kinsamanka/PICnc-V2/README.md

PICnc-V2
========

PICnc V2 is a PIC32 based hardware step generator board that is designed for MachineKit
