kinsamanka/PICnc-V2/(threads)

Thread 2 (2015-08-28):

Odroid compile vor image

magnifikus, 2015-08-28:
Im missing instructions to geht it working in the odroid, i the machinekit image You posted in odroid Forums (from march) but it seems to miss the drivers. Anyone bot an working image or do i have to Compiler linuxcnc myself?

Thanks in advance :)

adbensi, 2015-08-28:
Hello,
If You have Debian, You not need to build it, You can use debian package or
pre-build image iso. You can build too, but I can make it on Ubuntu with
old machinekit source.

But if You can open machinekit, then You need the picnc SPI source and HAL
files. You find it on the repository. What is Your version of the board?
Em 28/08/2015 15:25, "magnifikus" <notifications@github.com> escreveu:

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

magnifikus, 2015-08-29:
Using debian 7.8 with Linux machinekit 3.10.70-rt71 #1 SMP PREEMPT RT Fri Mar 13 06:54:06 UTC 2015 armv7l GNU/Linux

linuxcnc is sadly reporting as machinekit 0.1

if i run the test from the wiki its telling me the picnc module is missing, but i have no clue how to compile it and found nothing on the web.

if you have a tip, howto compile it would be nice

best regards

Moritz Kunze

kinsamanka, 2015-08-29:
If you have preempt_rt kernel running on Odriod, you can just follow the
instructions on the machinekit website on using the debian packages.

The 0.1 version is fixed, the actual version can be found on the log file.

Have you built the picnc board?
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

magnifikus, 2015-08-29:
yeah i created a prototype, the status is blinking, will experiment abit, and sorry for spamming issues here

magnifikus, 2015-08-29:
seems like its a bummer, kernel upgrade not working and the default kernel is crashing randomly (some kernel panic, could not write down :()

will try raspberry2, odroid seems to be engineered bad anyway.... guess you can close this :)

magnifikus, 2015-08-29:
sudo comp --install picnc.c  is btw the command i was looking for ;)

Closed 2015-08-29.

Thread 3 (2015-09-09):

Weired Missplacing

magnifikus, 2015-09-09:
Asking if someone uses picncv2 successfull and noticed random displacement of axis during programms.

Config is:
MAX_VELOCITY = 30
MAX_ACCELERATION = 40
STEPGEN_MAXACCEL = 45
SCALE = 640.0

running with G64 P0.05

wired happens sometime during programms, suddenly the X-Axis is ~20mm out of place, maybe someone had this issue also :)

running machinekit on odroid c1 with preempt

best regards

adbensi, 2015-09-09:
I use, I will simulate this... best regards
Em 09/09/2015 13:24, "magnifikus" <notifications@github.com> escreveu:

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

kinsamanka, 2015-09-09:
Do you observe this problem when using the sim configuration?

Please check the status of the picnc.spi_fault signal.

Asking if someone uses picncv2 successfull and noticed random displacement
of axis during programms.

Config is:
MAX_VELOCITY = 30
MAX_ACCELERATION = 40
STEPGEN_MAXACCEL = 45
SCALE = 640.0

running with G64 P0.05

wired happens sometime during programms, suddenly the X-Axis is ~20mm out
of place, maybe someone had this issue also :)

running machinekit on odroid c1 with preempt

best regards

—
Reply to this email directly or view it on GitHub
<https://github.com/kinsamanka/PICnc-V2/issues/3>.

Closed 2015-12-29.

Thread 5 (2015-12-18):

Need driver enable control

n9wxu, 2015-12-18:
Is the driver enable to be controlled by the PICnc automatically (ie. no steps in a while.. disable the driver) or should the enable outputs be controlled by machinekit?

kinsamanka, 2015-12-18:
The drive enabled pin is controlled by machinekit. But all the digital outputs are interlocked with the SPI communication, if there's activity on the SPI all the output pins will be cleared.

n9wxu, 2015-12-18:
So I simply need to map the enables to something in machine kit and the SPI update will drive the enables suitably?

I should probably de-assert the enables should the SPI timeout as well.

n9wxu, 2015-12-20:
Enable works...
Enable deasserts when the SPI timeouts.

Closed 2015-12-20.
