kinsamanka/PICnc-V2/hardware/LPT/PICnc_V2.pdf

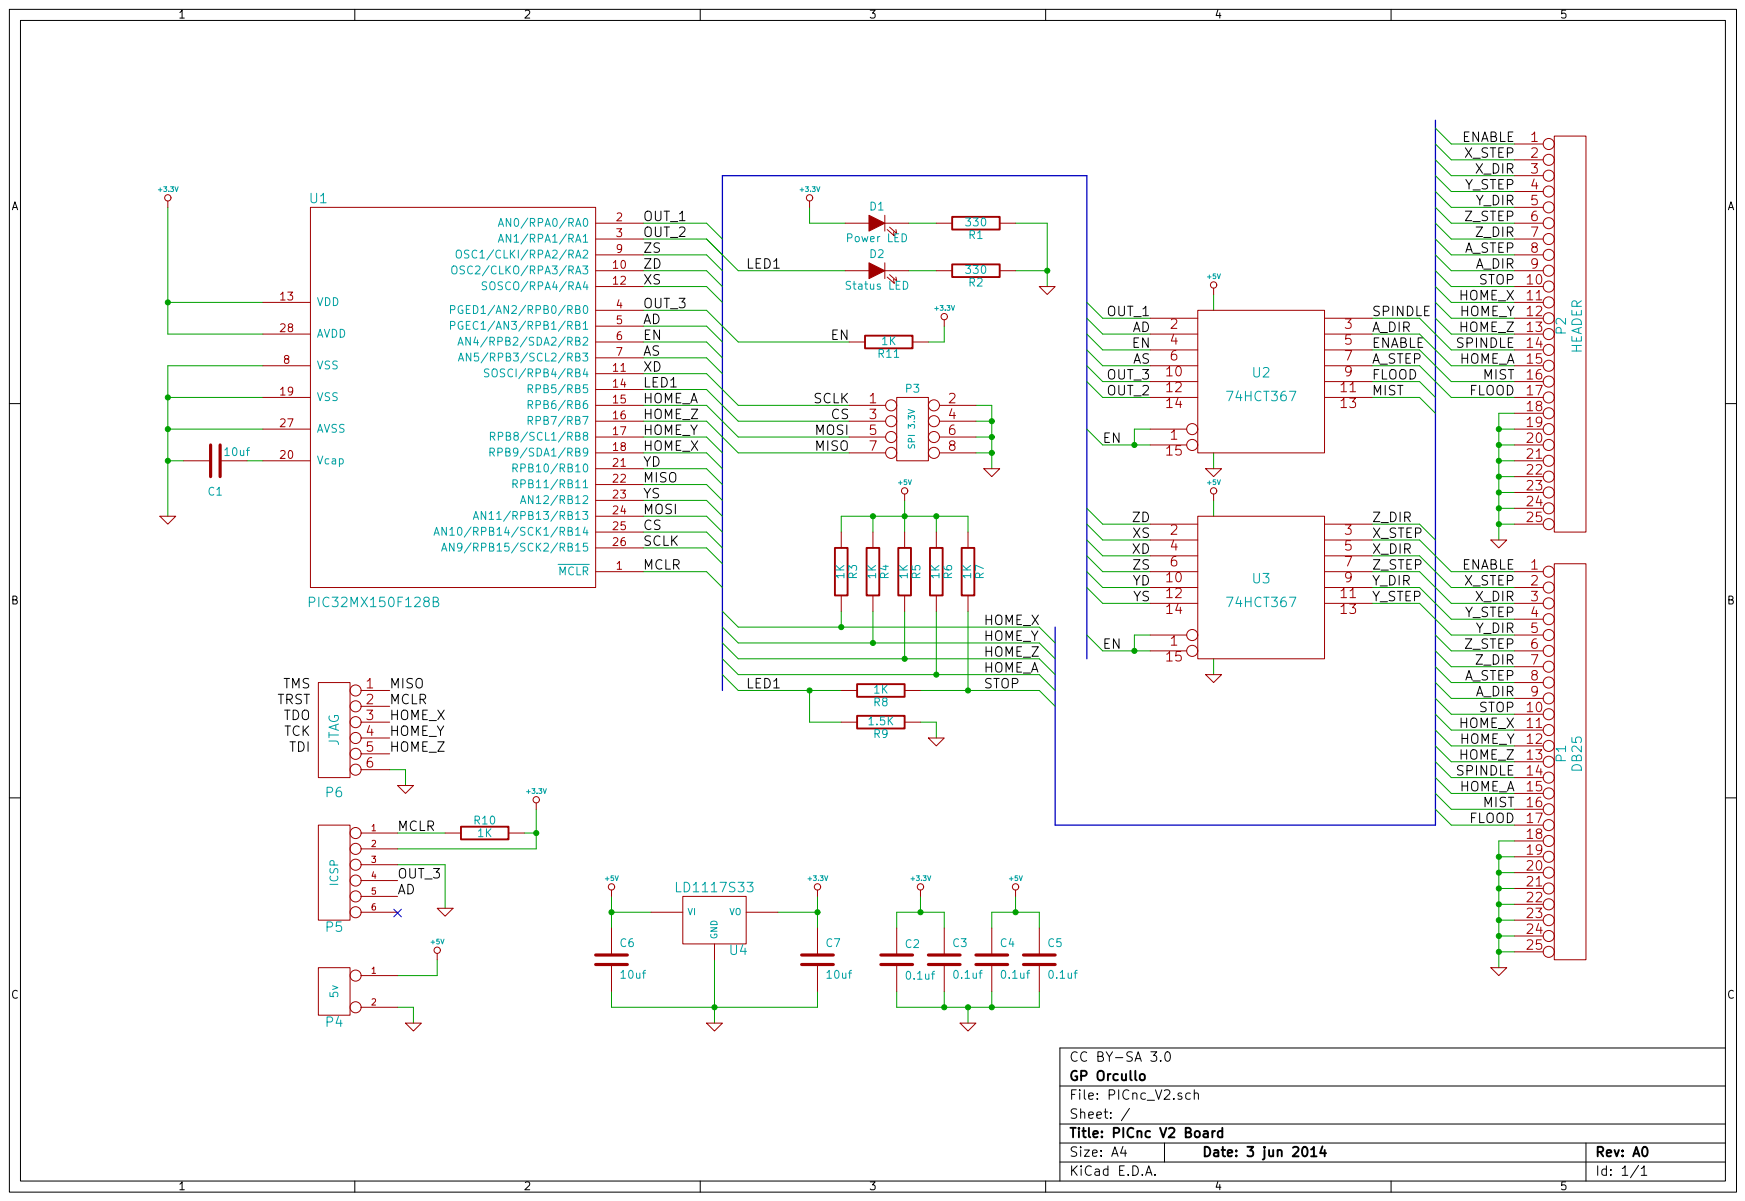
[picture p1: page 1]
