kinsamanka/PICnc-V2/hardware/Pololu/PICnc_V2_1.pdf

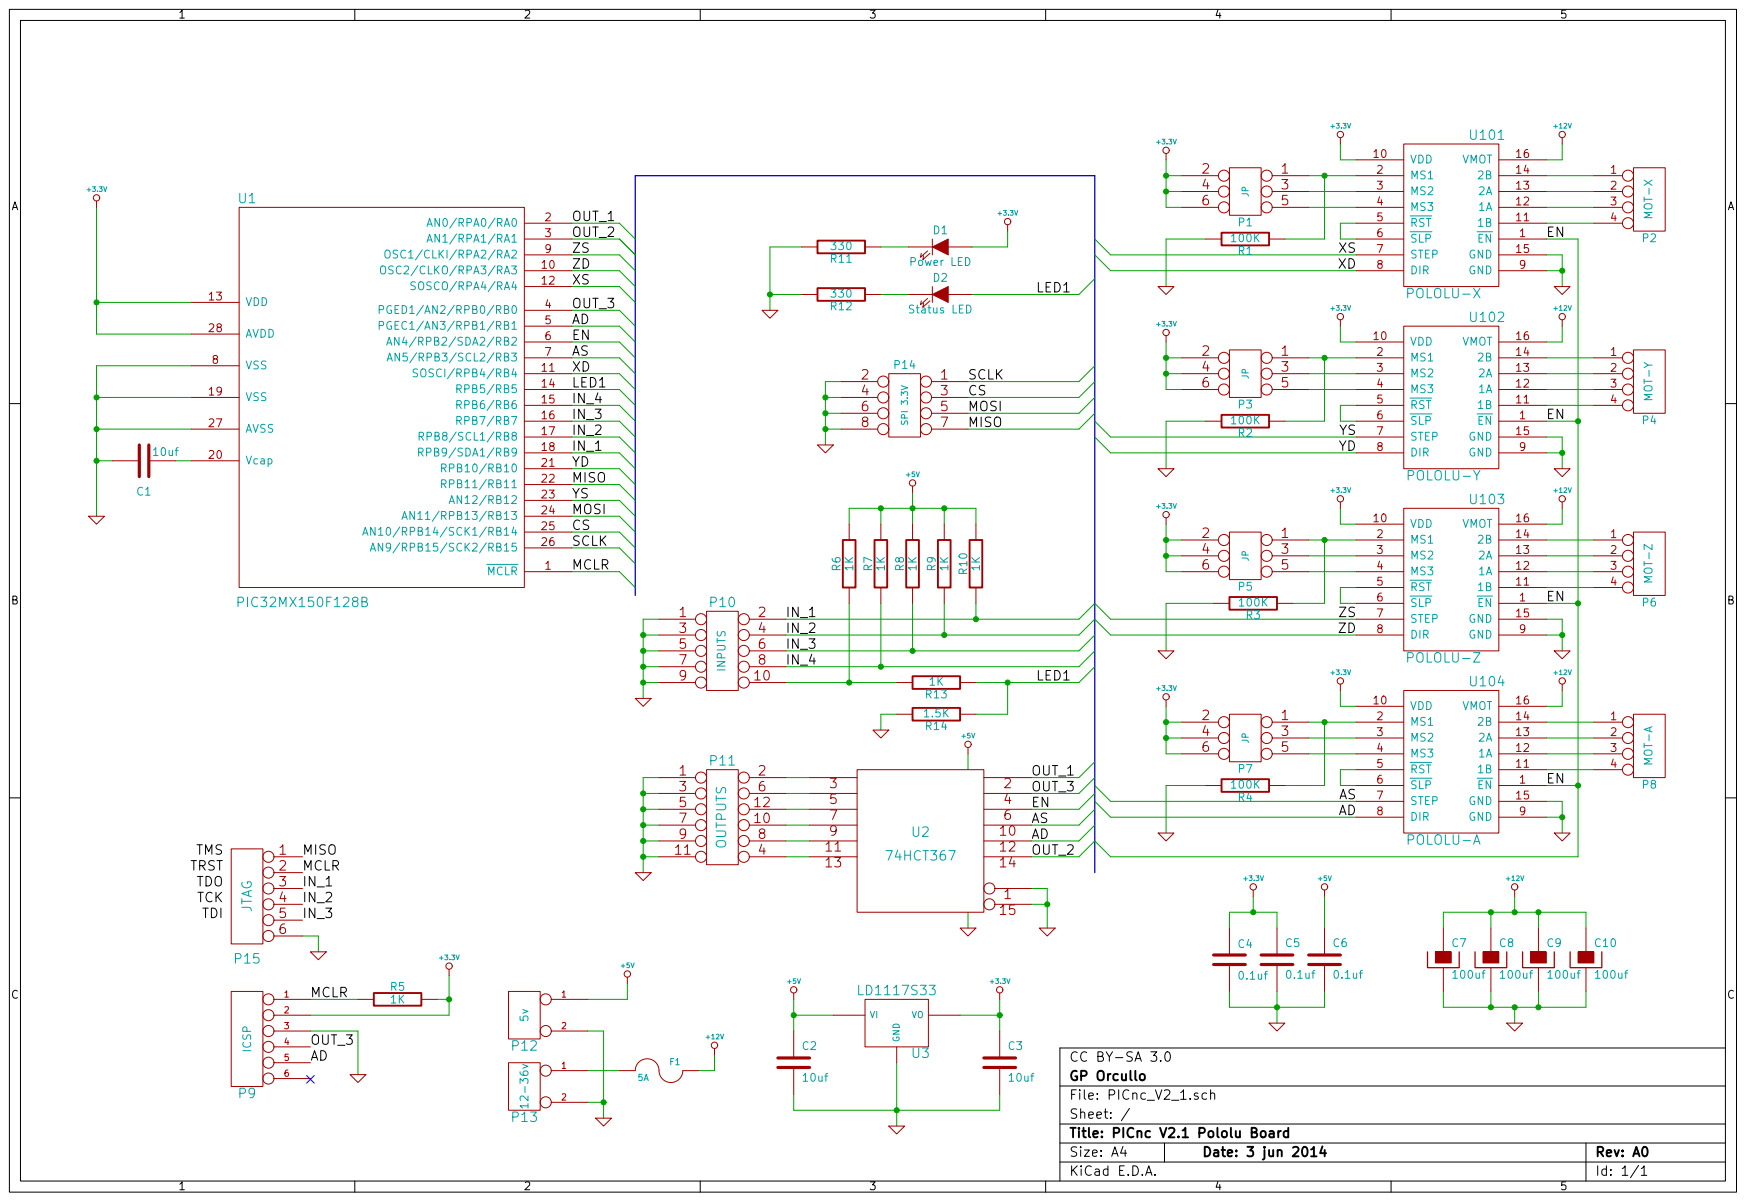
[picture p6: page 1]
