kinsamanka/PICnc-V2/hardware/Pololu/PICnc_V2_1_brd.pdf

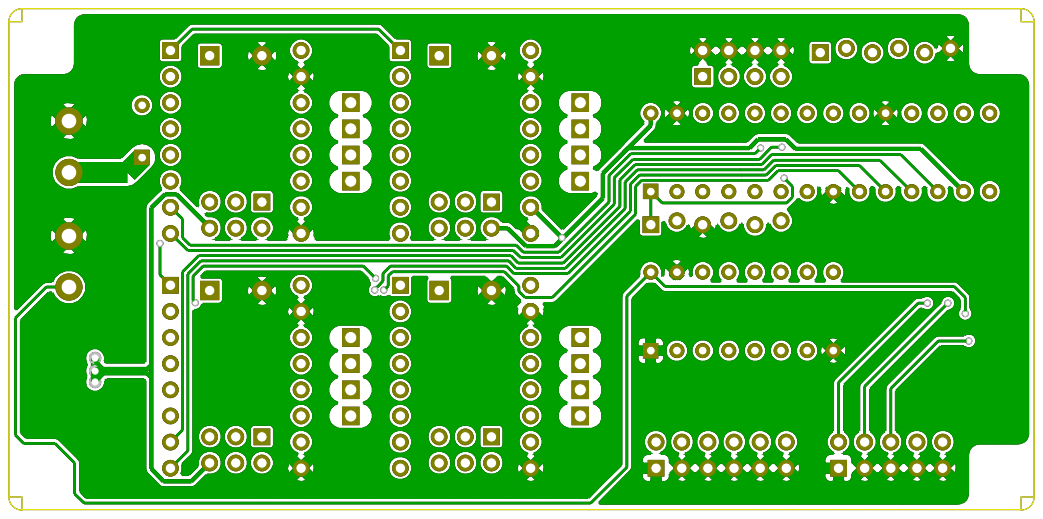
[picture p7: page 1]

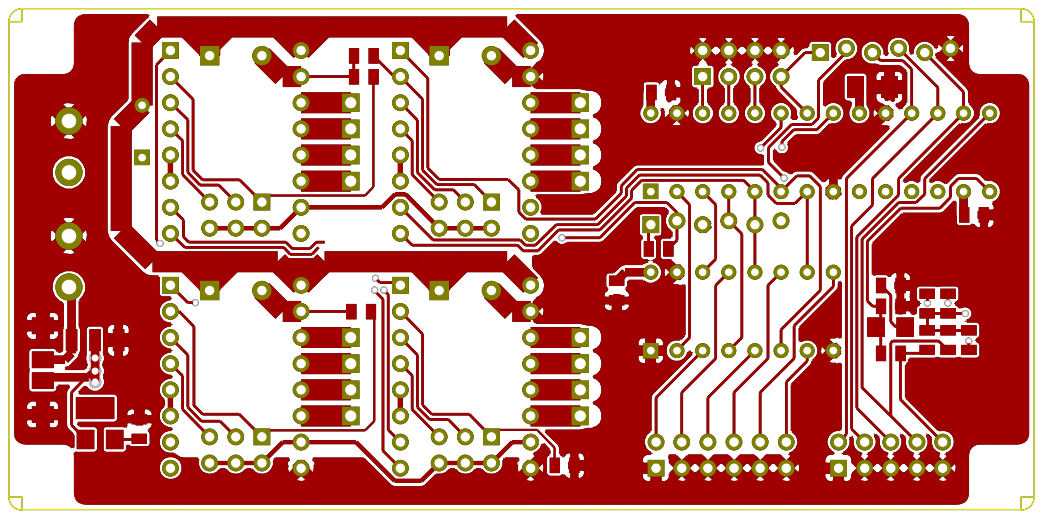
[picture p8: page 2]

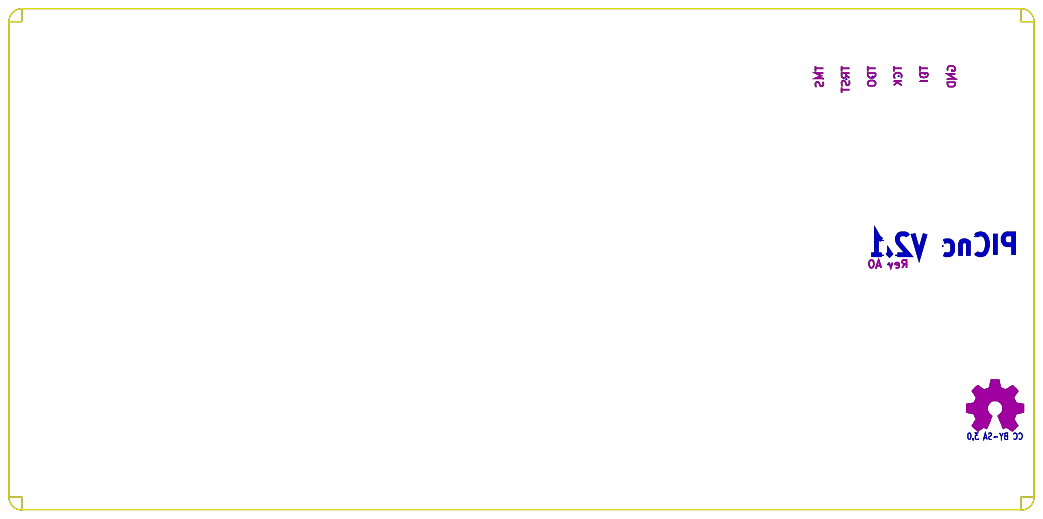
[picture p9: page 3]

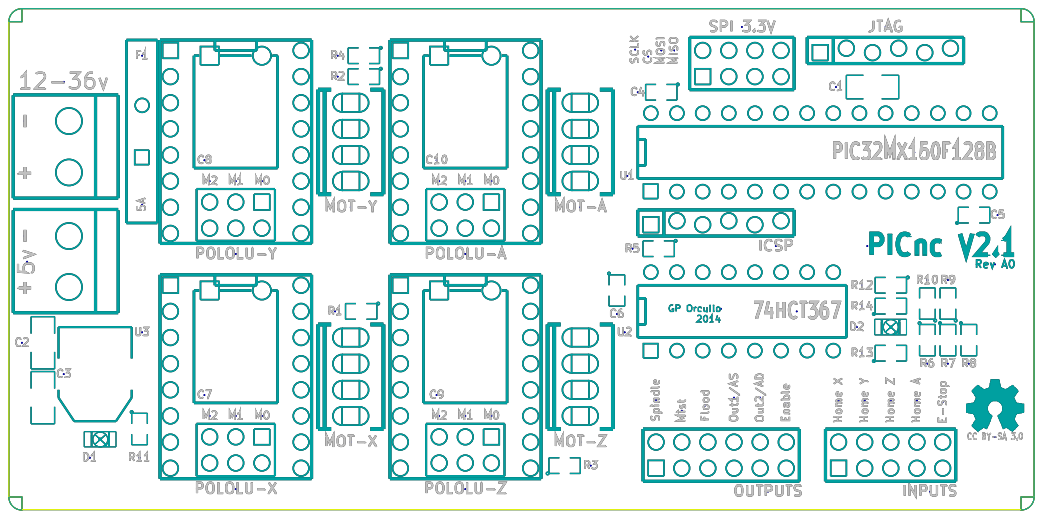
[picture p10: page 4]
