kinsamanka/PICnc-V2/hardware/LPT/PICnc_V2.sch

## KiCad design hardware/LPT/PICnc_V2.sch (2014-06-03)

Schematic: PICnc_V2.sch

Parts:
C1, C6, C7: 10uf; SM1206
C2, C3, C4, C5: 0.1uf; SM0805
D1: Power LED; LED-0603
D2: Status LED; LED-0603
P1: DB25
P2: HEADER
P3: SPI 3.3V
P4: 5v
P5: ICSP
P6: JTAG
R1, R2: 330; SM0805
R3, R4, R5, R6, R7, R8, R10, R11: 1K; SM0805
R9: 1.5K; SM0805
U1: PIC32MX150F128B
U2, U3: 74HCT367
U4: LD1117S33
