kinsamanka/PICnc-V2/hardware/Pololu/PICnc_V2_1.sch

## KiCad design hardware/Pololu/PICnc_V2_1.sch (2014-06-03)

Schematic: PICnc_V2_1.sch

Parts:
C1, C2, C3: 10uf; SM1206
C4, C5, C6: 0.1uf; SM0805
C7, C8, C9, C10: 100uf
D1: Power LED; LED-0603
D2: Status LED; LED-0603
F1: 5A
P1, P3, P5, P7: JP
P2: MOT-X
P4: MOT-Y
P6: MOT-Z
P8: MOT-A
P9: ICSP
P10: INPUTS
P11: OUTPUTS
P12: 5v
P13: 12-36v
P14: SPI 3.3V
P15: JTAG
R1, R2, R3, R4: 100K; SM0805
R5, R6, R7, R8, R9, R10, R13: 1K; SM0805
R11, R12: 330; SM0805
R14: 1.5K; SM0805
U1: PIC32MX150F128B
U2: 74HCT367
U3: LD1117S33
U101: POLOLU-X
U102: POLOLU-Y
U103: POLOLU-Z
U104: POLOLU-A
