kinsamanka/PICnc-V2/HAL/picnc.h

/*    Copyright (C) 2014 GP Orcullo
 *
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
 *    You should have received a copy of the GNU General Public License
 *    along with this program; if not, write to the Free Software
 *    Foundation, Inc., 51 Franklin St, Fifth Floor, Boston, MA  02110-1301 USA
 */

#ifndef PICNC_H
#define PICNC_H

enum pin_input_names {
	HOME_X,
	HOME_Y,
	HOME_Z,
	HOME_A,
	STOP
};

enum pin_output_names {
	SPINDLE,
	MIST,
	FLOOD,
	OUTPUT
};

typedef enum {
	UNSUPPORTED,
	RPI,
	RPI_2,
	ODROID_C1
} platform_t;

#define NUMAXES			4		/* X Y Z A*/
#define PWMCHANS		3
#define NUMOUTPUTS		4
#define NUMINPUTS		5

#define REQ_TIMEOUT		10000ul

#define SPIBUFSIZE		20		/* SPI buffer size */
#define BUFSIZE			(SPIBUFSIZE/4)

#define STEPBIT			22		/* bit location in DDS accum */
#define STEP_MASK		(1<<STEPBIT)

#define BASEFREQ		80000ul		/* Base freq of the PIC stepgen in Hz */
#define SYS_FREQ		(40000000ul)    /* 40 MHz */

#define PERIODFP 		((double)1.0 / (double)(BASEFREQ))
#define VELSCALE		((double)STEP_MASK * PERIODFP)
#define ACCELSCALE		(VELSCALE * PERIODFP)

#define get_position(a)		(rxBuf[1 + (a)])
#define update_velocity(a, b)	(txBuf[1 + (a)] = (b))

#define PAGE_SIZE		(4*1024)
#define BLOCK_SIZE		(4*1024)

#define CMD_CFG			0x4746433E
#define CMD_TST			0x5453543E
#define CMD_CM1			0x314D433E
#define CMD_CM2			0x324D433E
#define CMD_RST			0x5453523E

/* Broadcom defines */

#define BCM2835_SPICLKDIV	32		/* ~8 Mhz */

#define BCM2835_PERI_BASE	0x20000000
#define BCM2709_OFFSET		0x1F000000
#define BCM2835_GPIO_BASE	(BCM2835_PERI_BASE + 0x200000) /* GPIO controller */
#define BCM2835_SPI_BASE	(BCM2835_PERI_BASE + 0x204000) /* SPI controller */

#define BCM2835_GPFSEL0		*(mem1)
#define BCM2835_GPFSEL1		*(mem1 + 1)
#define BCM2835_GPFSEL2		*(mem1 + 2)
#define BCM2835_GPFSEL3		*(mem1 + 3)
#define BCM2835_GPFSEL4		*(mem1 + 4)
#define BCM2835_GPFSEL5		*(mem1 + 5)
#define BCM2835_GPSET0		*(mem1 + 7)
#define BCM2835_GPSET1		*(mem1 + 8)
#define BCM2835_GPCLR0		*(mem1 + 10)
#define BCM2835_GPCLR1		*(mem1 + 11)
#define BCM2835_GPLEV0		*(mem1 + 13)
#define BCM2835_GPLEV1		*(mem1 + 14)

#define BCM2835_SPICS 		*(mem2 + 0)
#define BCM2835_SPIFIFO     	*(mem2 + 1)
#define BCM2835_SPICLK 		*(mem2 + 2)

#define BCM_SPI_CS_DONE		0x00010000
#define BCM_SPI_CS_TA		0x00000080
#define BCM_SPI_CS_CLEAR_RX	0x00000020
#define BCM_SPI_CS_CLEAR_TX	0x00000010
#define BCM_SPI_CS_CPHA		0x00000004

/* Odroid C1 defines */

#define ODROID_FIFO_SIZE	16

#define ODROID_CBUS_PHY_BASE	0xC1100000
#define ODROID_GPIO_BASE	(ODROID_CBUS_PHY_BASE + 0x8000)
#define ODROID_GCLK_MPEG0	(ODROID_CBUS_PHY_BASE + 0x4000)

#define ODROID_PPMUX_3		*(mem1 + 0x2F)
#define ODROID_PPMUX_4		*(mem1 + 0x30)
#define ODROID_PPMUX_5		*(mem1 + 0x31)
#define ODROID_PPMUX_6		*(mem1 + 0x32)
#define ODROID_PPMUX_7		*(mem1 + 0x33)
#define ODROID_PPMUX_8		*(mem1 + 0x34)
#define ODROID_PPMUX_9		*(mem1 + 0x35)

#define ODROID_GPIOX_OEN	*(mem1 + 0x0C)
#define ODROID_GPIOX_PUEN	*(mem1 + 0x4C)
#define ODROID_GPIOX_PUPD	*(mem1 + 0x3E)

#define ODROID_SPI_RX		*(mem1 + 0x360)
#define ODROID_SPI_TX		*(mem1 + 0x361)
#define ODROID_SPI_CON		*(mem1 + 0x362)
#define ODROID_SPI_STAT		*(mem1 + 0x365)

#define ODROID_SPI_CLKGATE	*(mem2 + 0x50)

#endif
