kinsamanka/PICnc-V2/(commit log)

2014-06-03 hardware initial commit
    [PICnc_V2.brd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]
2014-06-07 added board outline
    [PICnc_V2-Back.gbl, PICnc_V2-Front.gtl, PICnc_V2-Mask_Back.gbs, PICnc_V2-Mask_Front.gts, PICnc_V2-PCB_Edges.gbr, PICnc_V2-SilkS_Back.gbo, PICnc_V2-SilkS_Front.gto, PICnc_V2_1-Back.gbl]
2014-08-15 initial commit for HAL driver and firmware
2014-10-30 fixed int32_t errors for the latest MPIDE compiler
    [main.c, stepgen.c]
2014-11-08 enabled PWM
2014-11-08 refactored HAL driver
2014-11-27 HAL/picnc.c: fixed param direction
    [picnc.c]
2015-04-08 changed SPI mode to make it compatible with Odroid C1
2015-04-14 fixed incorrect scale parameter
    [picnc.h, stepgen.c, stepgen.h]
