kinsamanka/PICnc-V2/(notices)

Notices in the files:
firmware/main.c:
This program is free software; you can redistribute it and/or modify
it under the terms of the GNU General Public License as published by
the Free Software Foundation; either version 3 of the License, or
(at your option) any later version.
HAL/picnc.c:
the Free Software Foundation; either version 2 of the License, or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
hardware/LPT/PICnc_V2.sch:
CC BY-SA 3.0
